seanmason/air-purifier-design/design/slim-v02/slim-v02.step

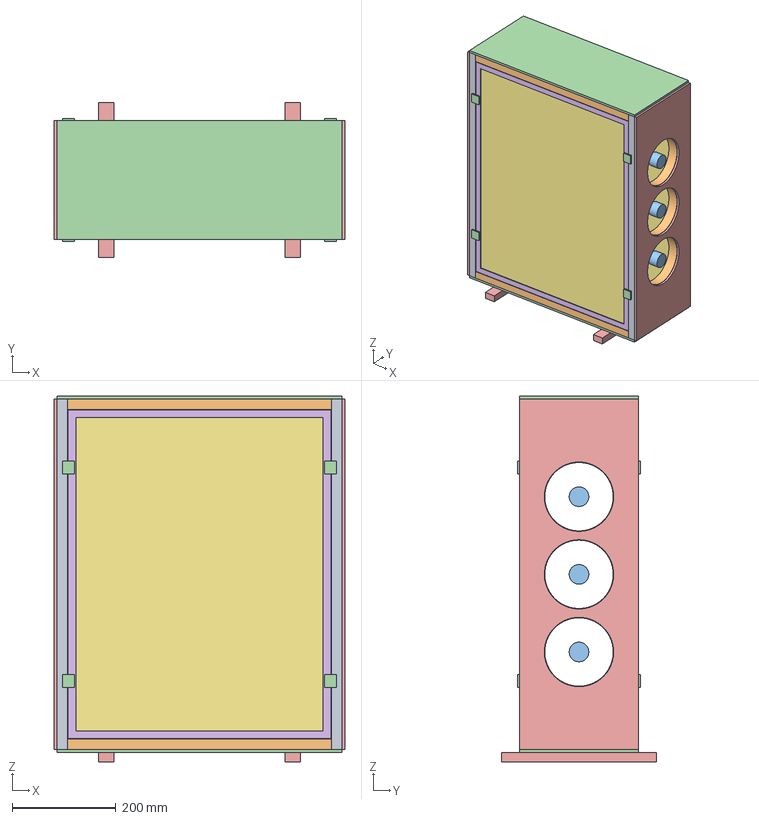
[picture p4: CAD file, 2026-10-27]
design/slim-v02/slim-v02.step
562.0 x 300.0 x 707.0 mm
