seanmason/air-purifier-design/design/nut-fit-v02/Sample_1_W10.0_bevel2.0.stl

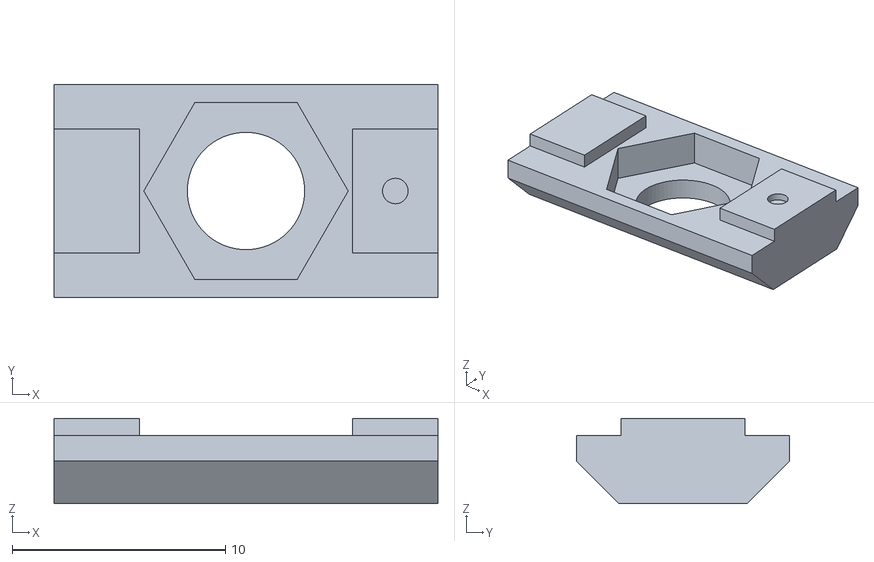
[picture p5: CAD file, 2026-10-27]
design/nut-fit-v02/Sample_1_W10.0_bevel2.0.stl
18.0 x 10.0 x 4.00
