seanmason/air-purifier-design/design/nut-fit-v02/nut-fit-v02.step

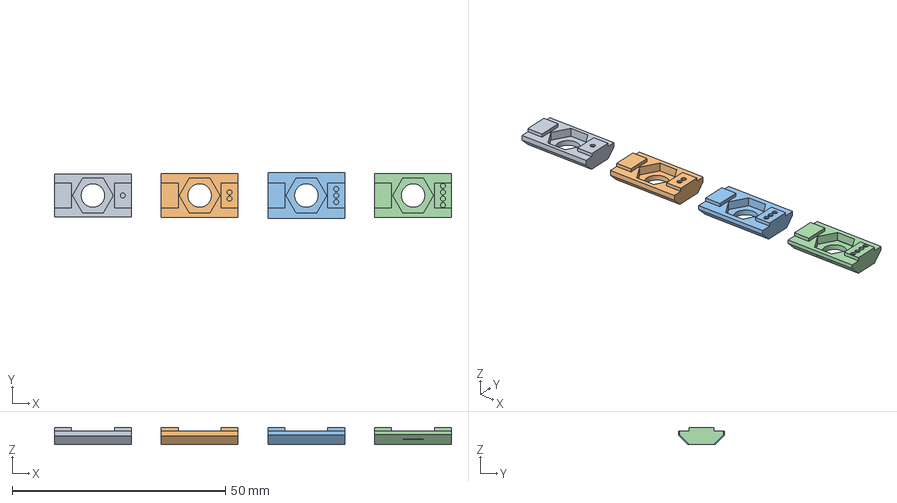
[picture p6: CAD file, 2026-10-27]
design/nut-fit-v02/nut-fit-v02.step
93.0 x 10.8 x 4.00 mm
