seanmason/air-purifier-design/design/nut-fit-v02/Sample_3_W10.8_bevel2.2.stl

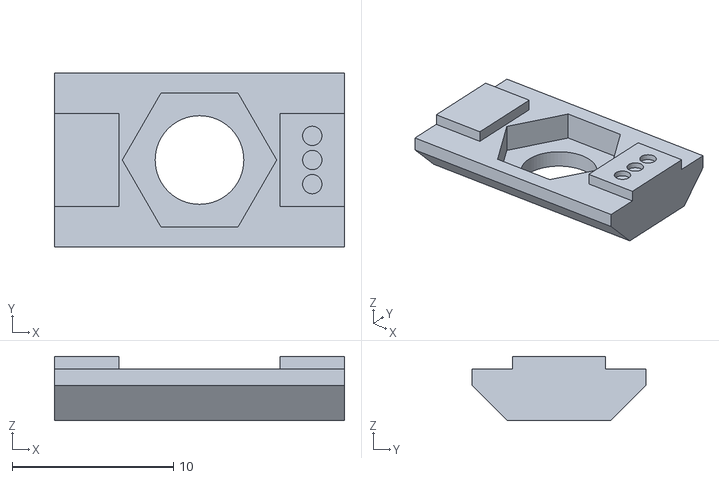
[picture p7: CAD file, 2026-10-27]
design/nut-fit-v02/Sample_3_W10.8_bevel2.2.stl
18.0 x 10.8 x 4.00
