seanmason/air-purifier-design/design/nut-fit-v02/Sample_4_W10.4_bevel2.3.stl

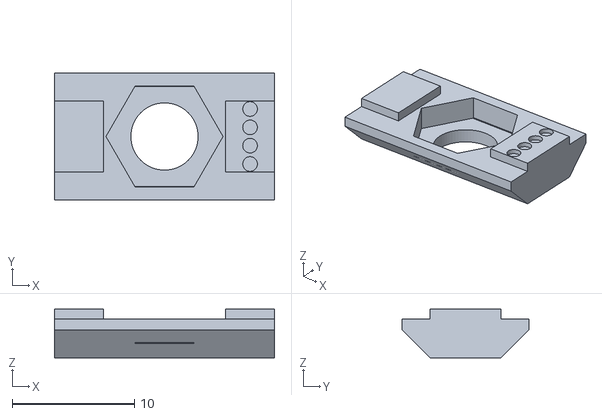
[picture p8: CAD file, 2026-10-27]
design/nut-fit-v02/Sample_4_W10.4_bevel2.3.stl
18.0 x 10.4 x 4.00
