seanmason/air-purifier-design/design/nut-fit-v02/Sample_2_W10.4_bevel2.0.stl

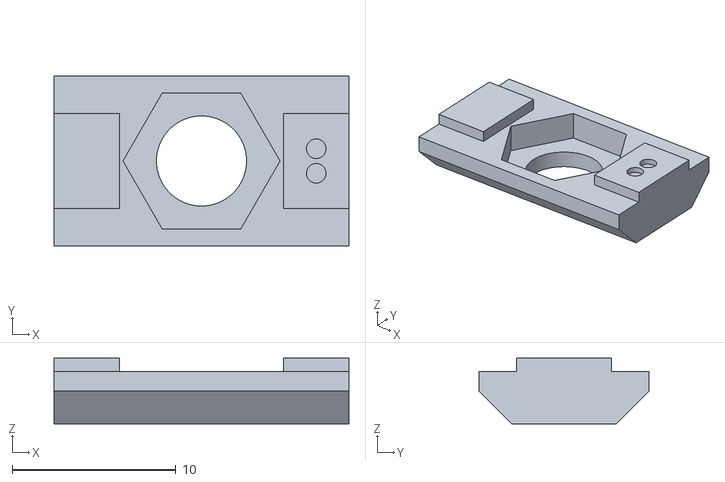
[picture p9: CAD file, 2026-10-27]
design/nut-fit-v02/Sample_2_W10.4_bevel2.0.stl
18.0 x 10.4 x 4.00
