seanmason/air-purifier-design/design/nut-fit-v01/fit-samples_MK4S-MMU3_0p6_Bambu-PETG-HF.3mf

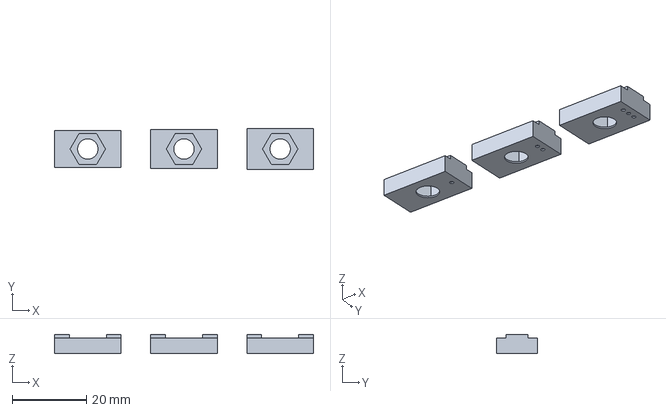
[picture p10: CAD file, 2026-10-27, an earlier design]
design/nut-fit-v01/fit-samples_MK4S-MMU3_0p6_Bambu-PETG-HF.3mf
70.0 x 11.0 x 5.20 mm
