seanmason/air-purifier-design/design/nut-fit-v01/carrier_2_width_10p5.stl

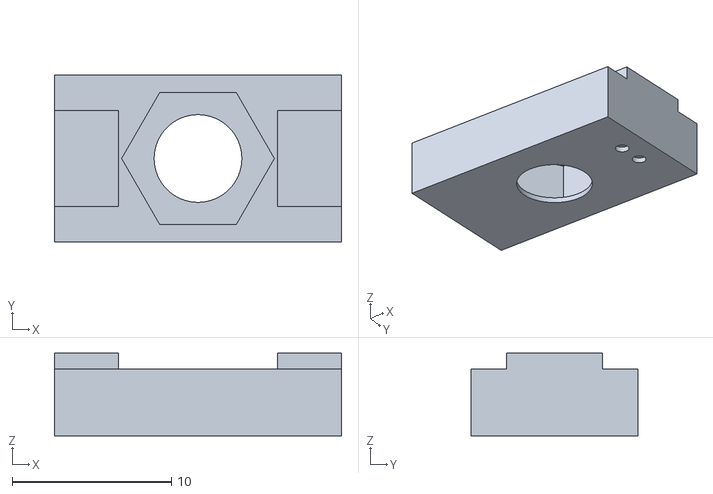
[picture p11: CAD file, 2026-10-27, an earlier design]
design/nut-fit-v01/carrier_2_width_10p5.stl
18.0 x 10.5 x 5.20
