seanmason/air-purifier-design/design/nut-fit-v01/carrier_3_width_11p0.stl

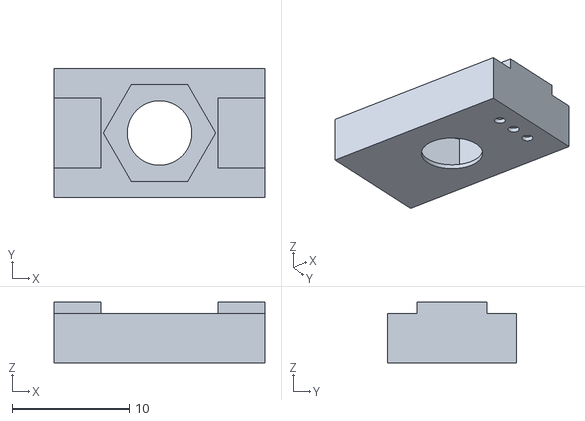
[picture p12: CAD file, 2026-10-27, an earlier design]
design/nut-fit-v01/carrier_3_width_11p0.stl
18.0 x 11.0 x 5.20
