seanmason/air-purifier-design/design/nut-fit-v01/carrier_1_width_10p0.stl

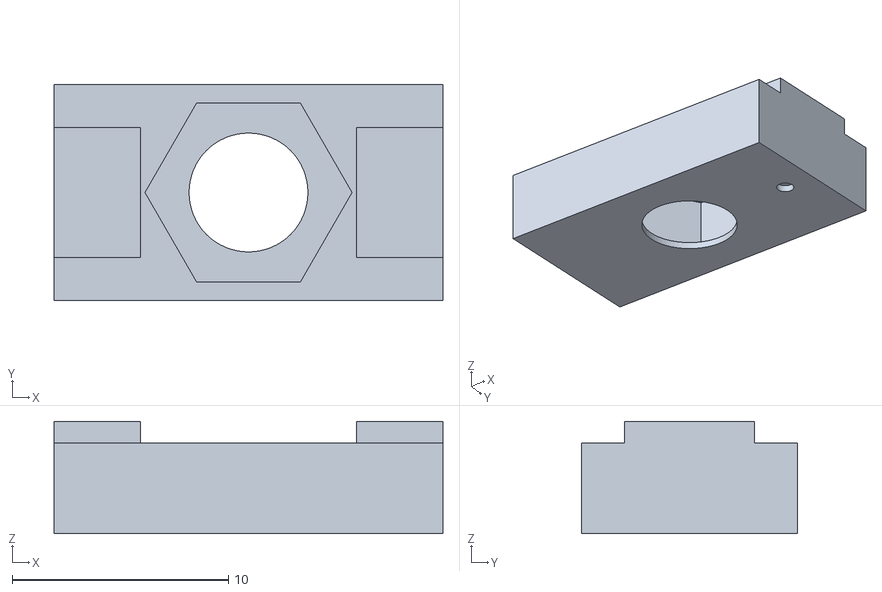
[picture p13: CAD file, 2026-10-27, an earlier design]
design/nut-fit-v01/carrier_1_width_10p0.stl
18.0 x 10.0 x 5.20
