seanmason/air-purifier-design/(list of files, cad)

Other CAD files:
design/nut-fit-v02/four-carriers.stl
design/nut-fit-v02/fit-v02_MK4S-MMU3_0p6_PETG-HF.3mf
design/nut-fit-v01/fit-samples_MK4S-MMU3_0p4_PETG.3mf
design/nut-fit-v01/nut-fit-v01.step
design/nut-fit-v01/three-carriers.stl
design/nut-fit-v01/nut-fit-v01.f3d
design/nut-fit-v02/nut-fit-v02.f3d
design/slim-v02/slim-v02.f3d
