seanmason/air-purifier-design/(commit log)

2026-10-27 Develop slim Fusion layout and multi-unit plan for open living space
    [slim-v02.f3d, slim-v02.step]
2026-10-27 Add printable M5 nut carrier fit samples and Prusa MK4S MMU3 slicing files
    [carrier_1_width_10p0.stl, carrier_2_width_10p5.stl, carrier_3_width_11p0.stl, fit-samples_MK4S-MMU3_0p4_PETG.3mf, nut-fit-v01.f3d, nut-fit-v01.step, three-carriers.stl]
2026-10-27 Prepare 0.6 mm Bambu PETG HF print and verify embedded 3MF settings
    [fit-samples_MK4S-MMU3_0p4_PETG.3mf, fit-samples_MK4S-MMU3_0p6_Bambu-PETG-HF.3mf]
2026-10-27 Revise nut carriers for measured sloped 2020 cavity
    [Sample_1_W10.0_bevel2.0.stl, Sample_2_W10.4_bevel2.0.stl, Sample_3_W10.8_bevel2.2.stl, Sample_4_W10.4_bevel2.3.stl, fit-v02_MK4S-MMU3_0p6_PETG-HF.3mf, four-carriers.stl, nut-fit-v02.f3d, nut-fit-v02.step]
2026-10-27 Record user-started v02 fit print and deferred PrusaLink setup
